LeeMinJun-git/dual_rs422_failover_soc_project/hardware/custom_ip/voltage_display_ip_1_0/waveforms/0_000.png

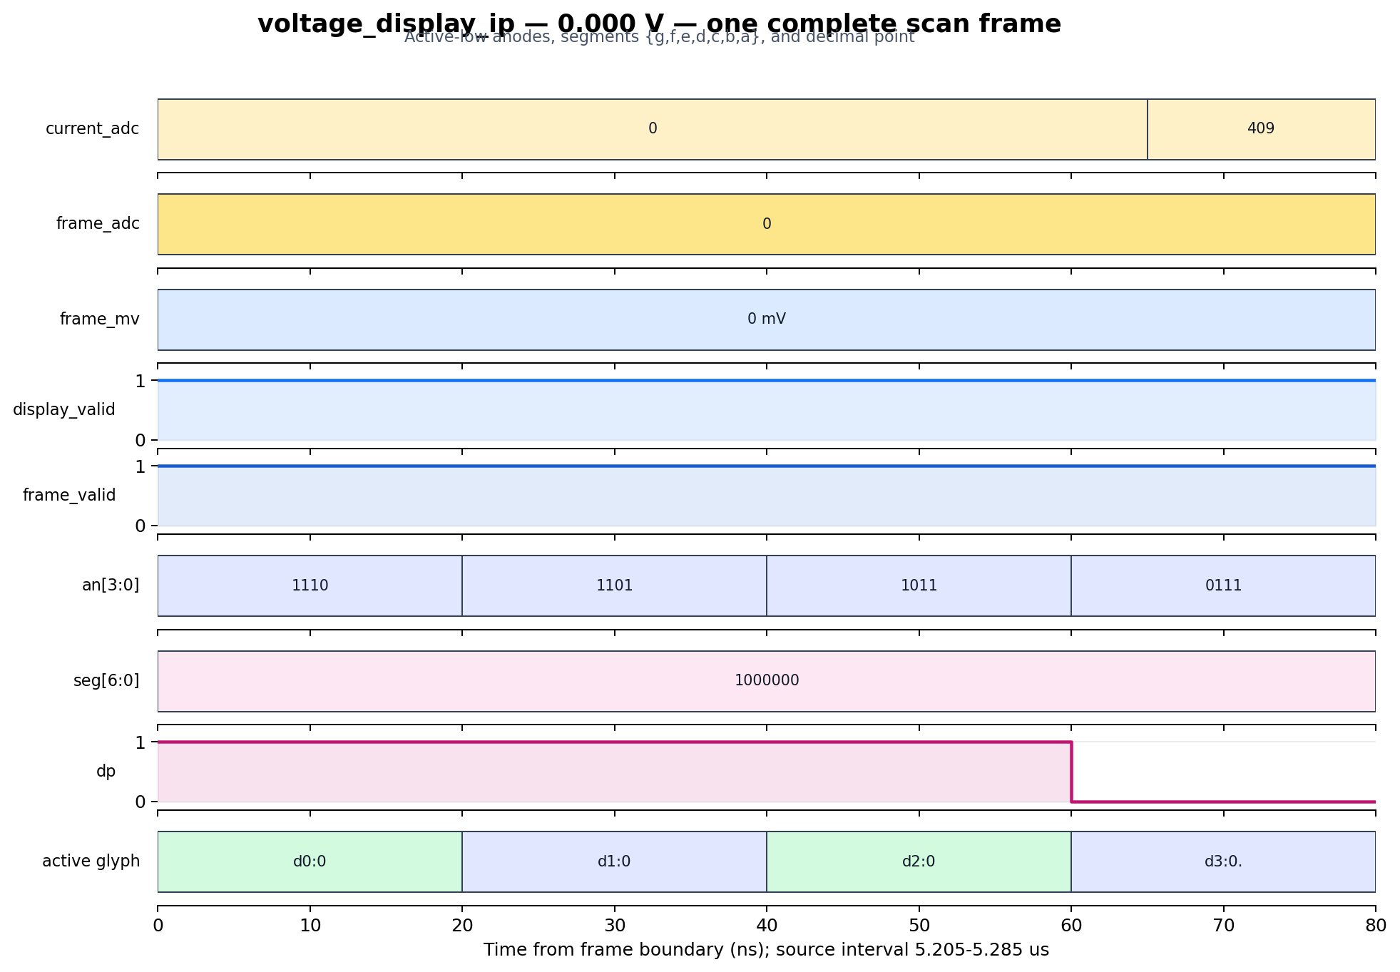
hardware/custom_ip/voltage_display_ip_1_0/waveforms/0_000.png
