LeeMinJun-git/dual_rs422_failover_soc_project/hardware/custom_ip/voltage_display_ip_1_0/waveforms/representative_overview.png

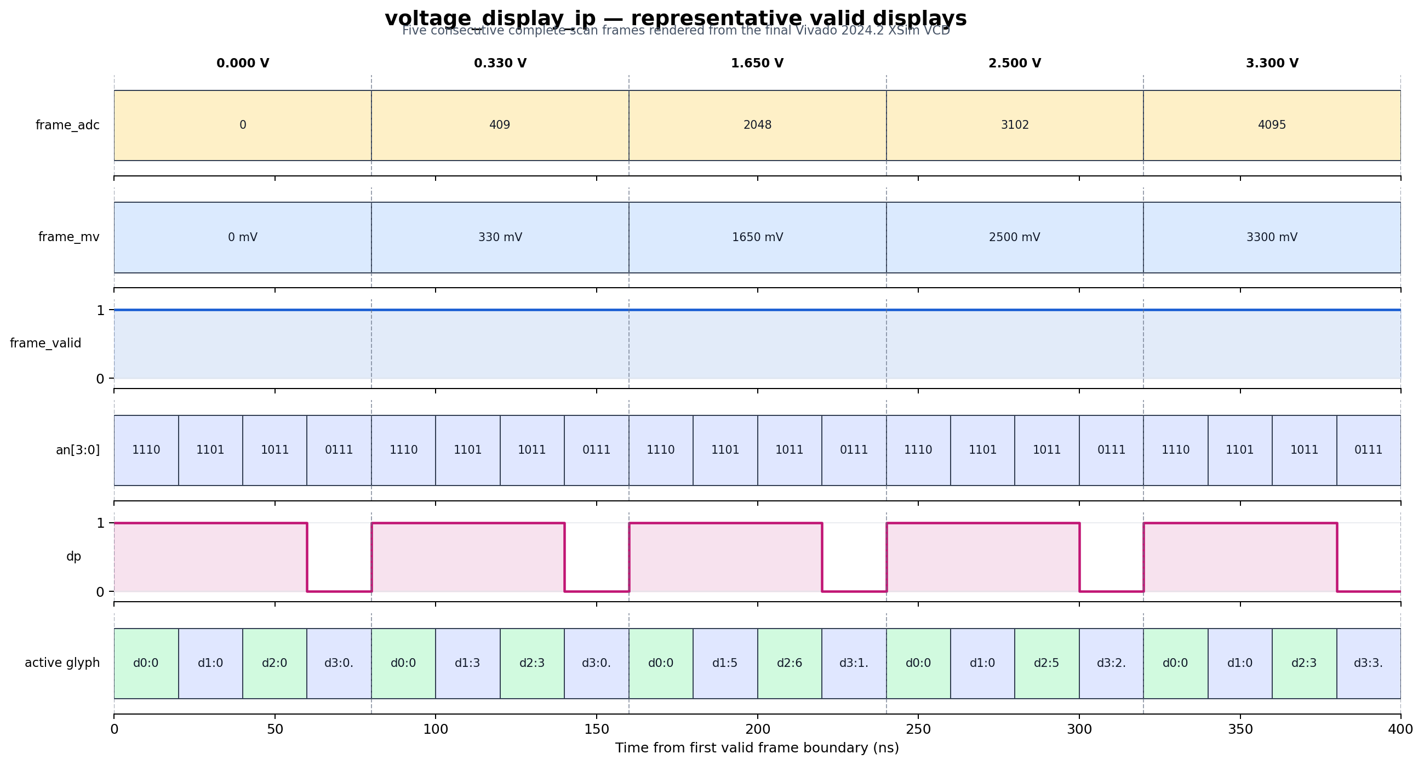
hardware/custom_ip/voltage_display_ip_1_0/waveforms/representative_overview.png
