LeeMinJun-git/dual_rs422_failover_soc_project/hardware/custom_ip/voltage_display_ip_1_0/reports/validation_summary.txt

VOLTAGE_DISPLAY_IP VALIDATION PASS
Simulation: VOLTAGE_DISPLAY_IP TEST PASS
Part: xc7a35tcpg236-1
Clock period: 10.000 ns
WNS: 5.708 ns
TNS: 0.000 ns
WHS: 0.339 ns
THS: 0.000 ns
VLNV: user.org:user:voltage_display_ip:1.0
Errors: 0
Critical warnings: 0
Warnings: 12
