LeeMinJun-git/dual_rs422_failover_soc_project/software/stm32/sender/Src/redundant_sender.h

#ifndef REDUNDANT_SENDER_H
#define REDUNDANT_SENDER_H

#ifdef __cplusplus
extern "C" {
#endif

void RedundantSender_Init(void);
void RedundantSender_Process(void);

#ifdef __cplusplus
}
#endif

#endif /* REDUNDANT_SENDER_H */
