LeeMinJun-git/dual_rs422_failover_soc_project/software/stm32/receiver/Src/redundant_receiver.h

#ifndef REDUNDANT_RECEIVER_H
#define REDUNDANT_RECEIVER_H

#ifdef __cplusplus
extern "C" {
#endif

void RedundantReceiver_Init(void);
void RedundantReceiver_Process(void);

#ifdef __cplusplus
}
#endif

#endif /* REDUNDANT_RECEIVER_H */
